skbecken/TreatTurbine/README.md

# The TreatTurbine

Autonomous UAV-mounted treat dispensing system developed in partnership with Alveus Sanctuary.

## Logo
<!-- PROJECT LOGO -->
<br />
<div align="center">
<a href="https://github.com/skbecken/TreatTurbine">
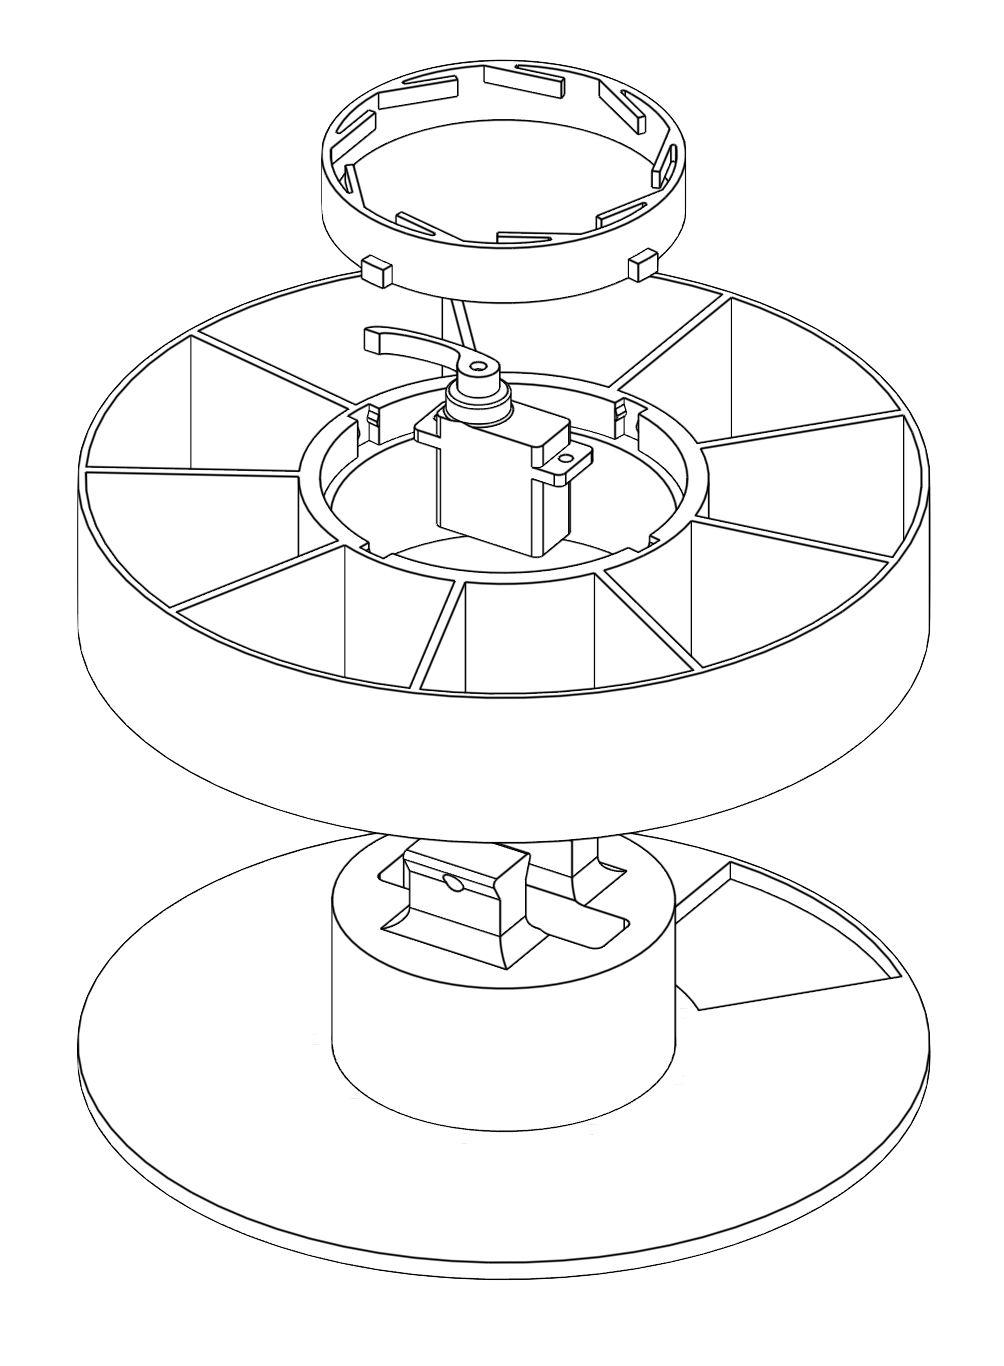
[picture p1: assets/diagrams/TreatTurbine_Exploded_View.png]

</a>

<h1 align="center">TreatTurbine</h1> 

 <p align="center">
    Autonomous UAV-mounted treat dispensing system developed in partnership with Alveus Sanctuary.
  </p>
  </div>

## Table of Contents
- Overview  
- Features  
- Hardware / Requirements  
- Getting Started  
- Usage  
- Documentation  
- Contributing  
- License  
- Contact  
- Acknowledgements  

## Overview
This system is designed to deliver small treats via an unmanned aerial vehicle (UAV). Its advantages include the capability to reach remote areas, perform pre-programmed jobs, and keep people far away from the animals it serves.

## Features
- Versatile design that works with different payloads and drone platforms  
- Designed to be inexpensive, easy to manufacture, and easy to use  

## Hardware / Requirements
What someone needs before they can use this system.

## Getting Started
Step-by-step instructions for going from zero to a working system.

## Usage
Instructions for operating the system once it is set up. Screenshots or diagrams may be helpful here.

## Documentation
To make the TreatTurbine more accessible, significant effort has been put into documenting the steps required to reproduce it. Instructions, usage notes, 3D print files, and software can be found in this GitHub repository.

A complete version of the Onshape CAD files, ready for modification, can be found here:  
https://cad.onshape.com/documents/a14a263d4646380f37314a8a/w/1a27b2a84b8e4b9b2ac841da/e/305afa125aeae7e1aa674fe5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

## Contributing
See `CONTRIBUTING.md` for contribution guidelines.

## License
Apache 2.0 License  
https://github.com/skbecken/TreatTurbine/blob/main/LICENSE

## Contact
- Sophia Becken — skbecken@bu.edu  
- Aidan Donovan — aidanmd@bu.edu  
- Harrison Grant — hgrant@bu.edu  
- Sofia Kamal — skamal9@bu.edu  
- Jason Sayah — jsnsayah@bu.edu  

Project Link:  
https://github.com/skbecken/TreatTurbine/tree/main

## Acknowledgements
- Alveus Sanctuary  
- Boston University  
- RASTIC  
- Team 223
