skbecken/TreatTurbine/06_Preflight_Checklist/preflight_checklist.md

#### The Ground Station
- [ ] Computer is charged for the duration of the flight
- [ ] Computer will not overheat/freeze in the elements
- [ ] Alerts are both visible and audible (test by changing flight mode while disarmed)
- [ ] SiK radio antenna has a clear view and is oriented correctly (pointed up in most conditions)
- [ ] Radio controller is adequately charged
- [ ] The autonomous flight path is valid
- [ ] Failsafe path and altitude are set correctly
- [ ] There are no gyro, accelerometer, GPS errors, or other critical error

#### The Aircraft
- [ ] Each propellor: snugly tightened CW and CCW, as appropriate 
- [ ] Wires: no loose or dangling wires close to propellors
- [ ] Battery voltage is appropriate for flight, but under no circumstances lower than 3.7V/cell (14.8V for a 4s battery) - note that reported percentage can be very misleading
- [ ] Takeoff/landing zone is clear (10ft radius with open sky)
- [ ] Good GPS lock (HDOP <1.2 and 8+ satellites)
- [ ] Battery is secure (passes wiggle test)
- [ ] Battery leads have tension and are not at risk of getting into props
- [ ] Compass is giving sane readings (verify North reads North etc)

#### The Pilot 
- [ ] IMSAFE 
  - [ ] Illness
  - [ ] Medication
  - [ ] Sleep
  - [ ] Alcohol
  - [ ] Fatigue
  - [ ] Emotion
- [ ] Adequate sunglasses/glasses for the distance and direction of flight
- [ ] Is confident in both their abilities and in the technical soundness of the aircraft

#### Regulatory (important, but not safety critical)
- [ ] Remote ID is charged and active
- [ ] Not operating in a no-fly zone
- [ ] Part 107 pilot present for any and all commercial operation
- [ ] Flight will not exceed visual line of site (or spotters are present along the way) without waiver
