skbecken/TreatTurbine/06_Preflight_Checklist/before_first_flight.md

check motor directions
check accels
do test while holding
PSU smoke test
calibrations
