skbecken/TreatTurbine/README_OLD.md

<!-- PROJECT LOGO -->
<br />
<div align="center">
<a href="https://github.com/skbecken/TreatTurbine">

</a>

<h1 align="center">TreatTurbine</h1> 

 <p align="center">
    Autonomous UAV-mounted treat dispensing system developed in partnership with Alveus Sanctuary.
  </p>
  </div>
  
<h2 align="left">Table of Contents</h2>

<h2 align="left">Overview</h2>
  <p align="left">
    This system is designed to deliver small treats via an unmanned aerial vehicle (UAV). Its advantages include the capability to reach remote areas, perform pre-programmed jobs, and keeping people far away from the animals it serves. 
  </p>
  </div>
  
<h2 align="left">Features</h2>
  <p align="left">
    - Versatile, designed to work with different payloads and different drone platforms
    - Designed to be cheap, easy to manufacture, and easy to use
    - 
  </p>
  </div>
  
<h2 align="left">Hardware / Requirements</h2>
  <p align="left">
    What someone needs before they can use this.
  </p>
  </div>
  
<h2 align="left">Getting Started</h2>
  <p align="left">
    Step by step — how to get from zero to working.
  </p>
  </div>

<h2 align="left">Usage</h2>
  <p align="left">
    How to actually operate it once set up.
    Screenshots or diagrams help here.
  </p>
  </div>

<h2 align="left">Documentation</h2>
  <p align="left">
    In order to make the Treat Turbine more accessible, considerable effort has gone into documenting and recording the steps required to reproduce it. Instructions, usage notes, 3D print files, and software, can be found in this Github repo. A complete version of the Onshape CAD files ready for your modifications can be found here: https://cad.onshape.com/documents/a14a263d4646380f37314a8a/w/1a27b2a84b8e4b9b2ac841da/e/305afa125aeae7e1aa674fe5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
  </p>
  </div>

<h2 align="left">Contributing</h2>
  <p align="left">
    Brief note + link to CONTRIBUTING.md
  </p>
  </div>

<h2 align="left">License</h2>
  <p align="left">
    Apache 2.0 License — \[LICENSE.md\](https://github.com/skbecken/TreatTurbine/blob/main/LICENSE)
  </p>
  </div>

<h2 align="left">Contact</h2>
<p align="left">
 
Sophia Becken - skbecken@bu.edu 

Aidan Donovan - aidanmd@bu.edu

Harrison Grant - hgrant@bu.edu

Sofia Kamal - skamal9@bu.edu

Jason Sayah - jsnsayah@bu.edu

Project Link: https://github.com/skbecken/TreatTurbine/tree/main
</p>
</div>

<h2 align="left">Acknowledgements</h2>
  <p align="left">
    Alveus Sanctuary, Boston University, RASTIC, Team 223
  </p>
  </div>
