skbecken/TreatTurbine/assets/diagrams/TreatTurbine_Exploded_S550.png

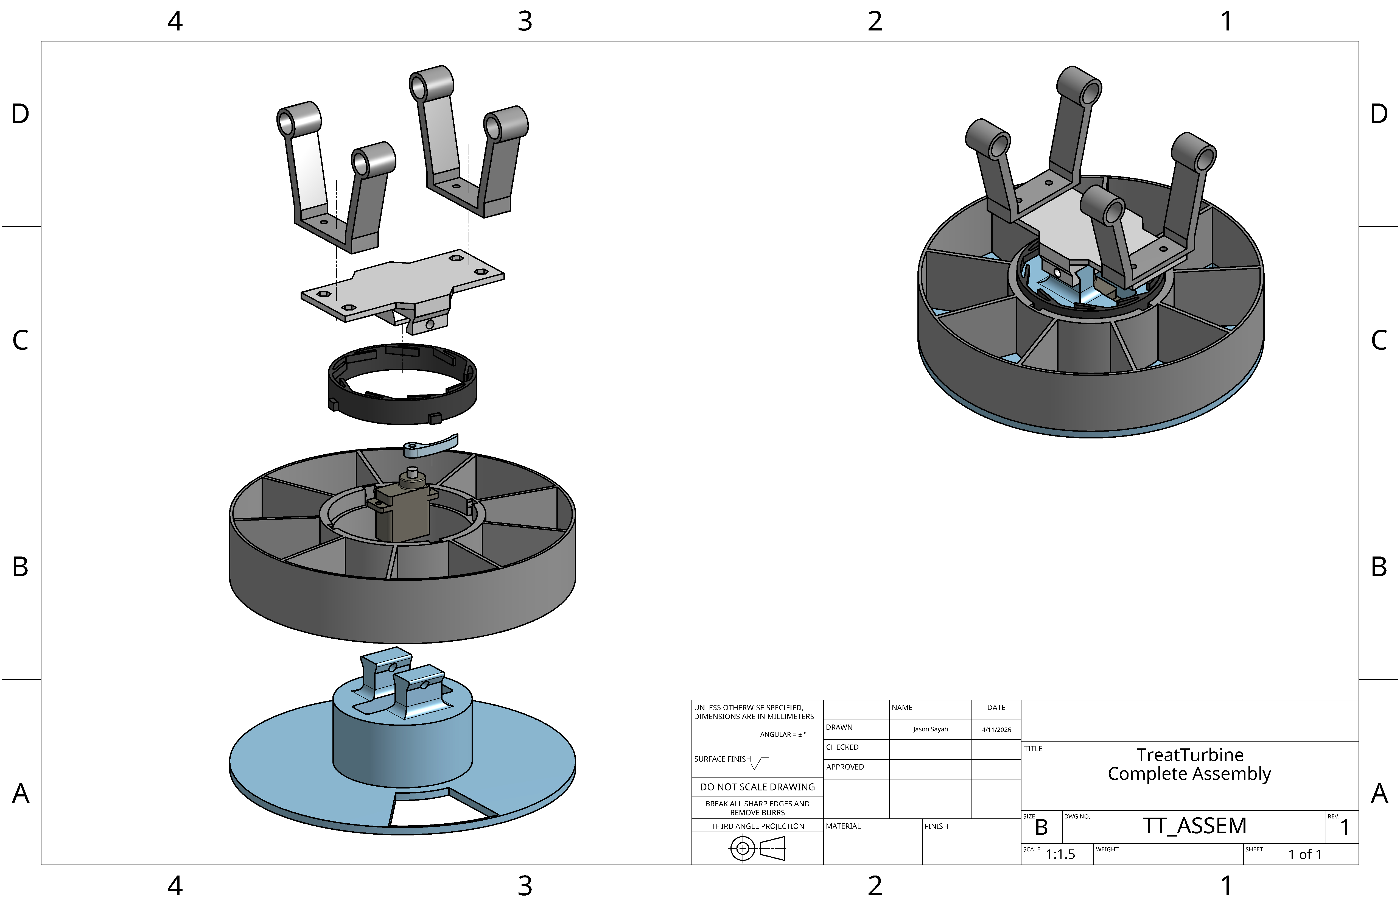
assets/diagrams/TreatTurbine_Exploded_S550.png
