skbecken/TreatTurbine/assets/photos/Team_Photo.jpg

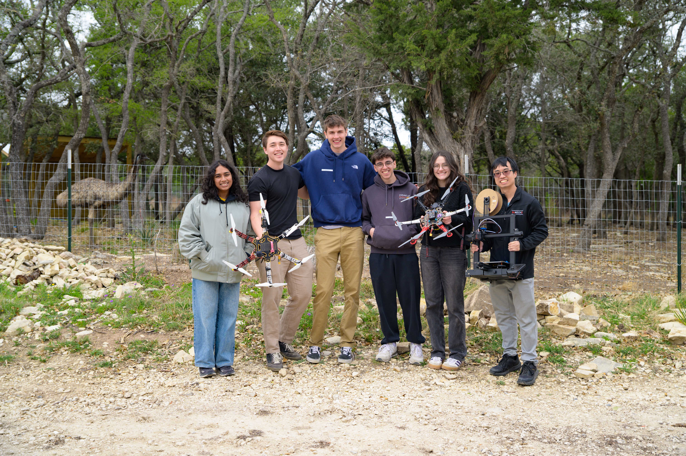
assets/photos/Team_Photo.jpg
