skbecken/TreatTurbine/assets/Screenshots/intro-to-Q.png

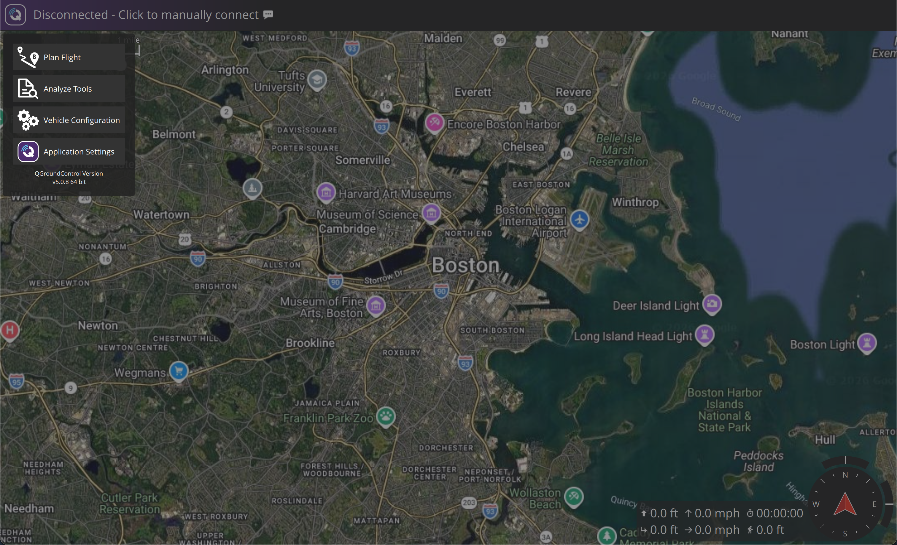
assets/Screenshots/intro-to-Q.png
