skbecken/TreatTurbine/01_Bill_of_Materials/bill_of_materials.md

# 01 - Bill of Materials

## What you can find here

- A complete breakdown of components our team used to build and fly the S550 autonomously while streaming video
- A complete breakdown of components in the TreatTurbine
- Information on part sourcing and cost

Note: These lists simply represent the parts Team 223 used in developing this project. Viable alternatives exist and are left to user discretion. 

## 

## S550 BOM

| Item | Part | Source | Cost |
|---|---|---|---|
| 1 | S550 Hexacopter Pack | Amazon | $299.99 |
| 2 | FrSky X8R Radio Receiver | Amazon | $38.99  |
| 3 | M8N GPS Module | Amazon | $31.24  |
| 4 | 3DR 500MW Radio Telemetry Kit | Amazon | $63.99  |
| 5 | 4S 6000 mAh LiPo Batteries | Ovonic | $66.64  |
| 6 | Walksnail Avatar VRX | RaceDayQuads | $262.99 |
| 7 | Walksnail Avatar GT VTX | RaceDayQuads | $235.99 |
| 8 | RadioMaster Pocket Radio | GetFPV | $71.49  |

## 

## TreatTurbine BOM

| Item | Part | Source | Weight (g) | Estimated Cost |
|---|---|---|---|---|
| 1 | Baseplate | 3D Print | 56 | $2.07 |
| 2 | Divider | 3D Print | 60.5 | $2.24 |
| 3 | Gear Ring | 3D Print | 6.3 | $0.20 |
| 4 | Servo Pawl | 3D Print | 0.3 | $0.01 |
| 5 | Mounting Plate and Sling | 3D Print | 22.6 | $0.84 |
| 6 | Camera Cage | 3D Print | 1.8 | $0.07 |
| 7 | Camera Mount | 3D Print | 3.1 | $0.10 |
| 8 | SG90 Servo | Amazon | 10 | $2.00 |
| 9 | 3mm x 3mm Magnets | Amazon | | $8.50 |
