skbecken/TreatTurbine/10_3D_Print_Files/servo_pawl.stl

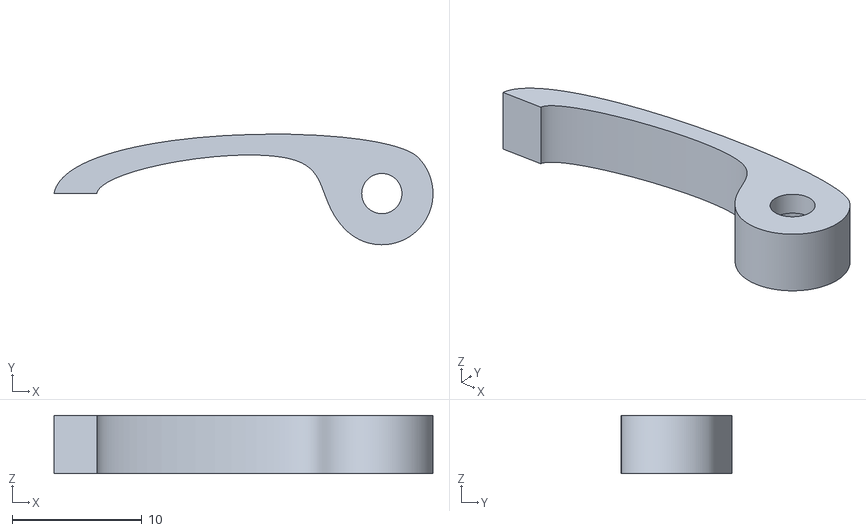
[picture p5: CAD file, 2026-04-06]
10_3D_Print_Files/servo_pawl.stl
29.2 x 8.53 x 4.50
