skbecken/TreatTurbine/10_3D_Print_Files/baseplate.stl

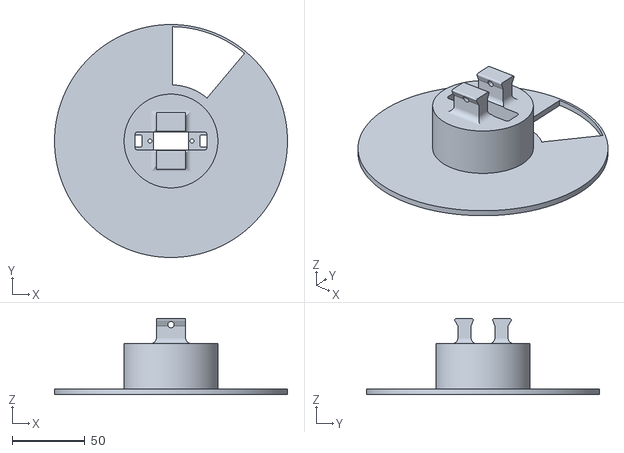
[picture p6: CAD file, 2026-04-06]
10_3D_Print_Files/baseplate.stl
160.0 x 160.0 x 52.2
