skbecken/TreatTurbine/10_3D_Print_Files/divider.stl

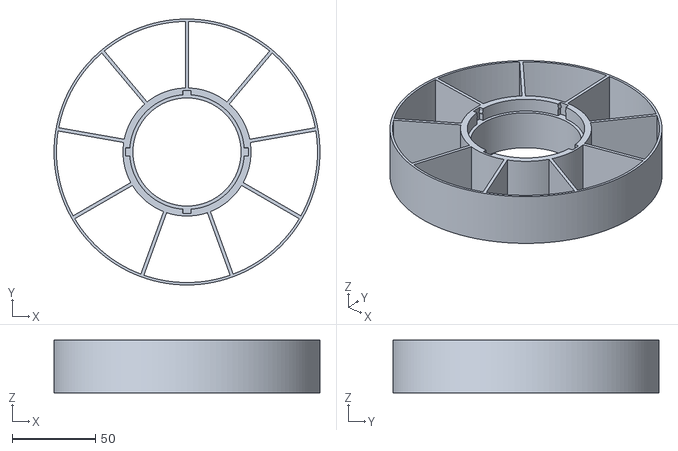
[picture p7: CAD file, 2026-04-06]
10_3D_Print_Files/divider.stl
160.0 x 160.0 x 31.8
