skbecken/TreatTurbine/10_3D_Print_Files/sling_plate.stl

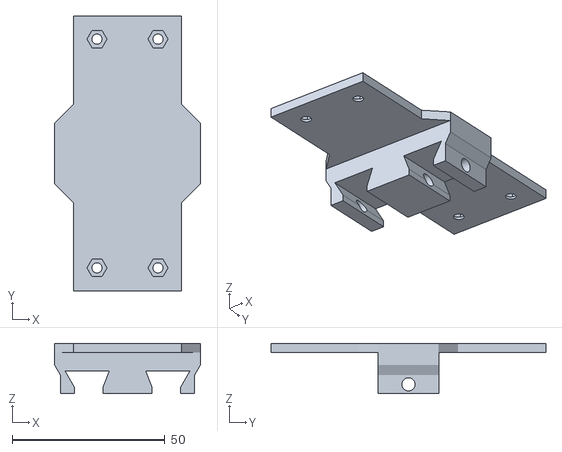
[picture p8: CAD file, 2026-04-06]
10_3D_Print_Files/sling_plate.stl
47.8 x 90.0 x 16.4
