skbecken/TreatTurbine/10_3D_Print_Files/gear_ring.stl

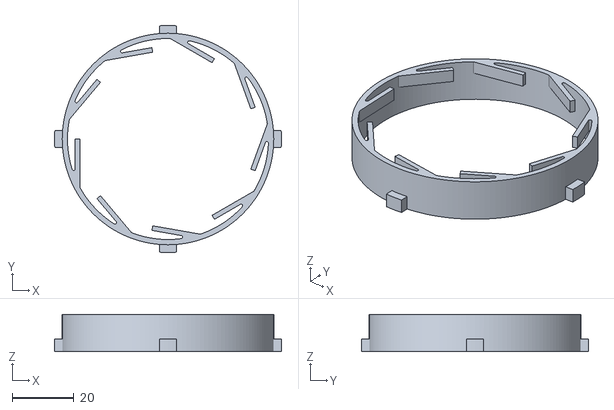
[picture p9: CAD file, 2026-04-06]
10_3D_Print_Files/gear_ring.stl
73.4 x 73.4 x 12.0
