skbecken/TreatTurbine/10_3D_Print_Files/sling_arm.stl

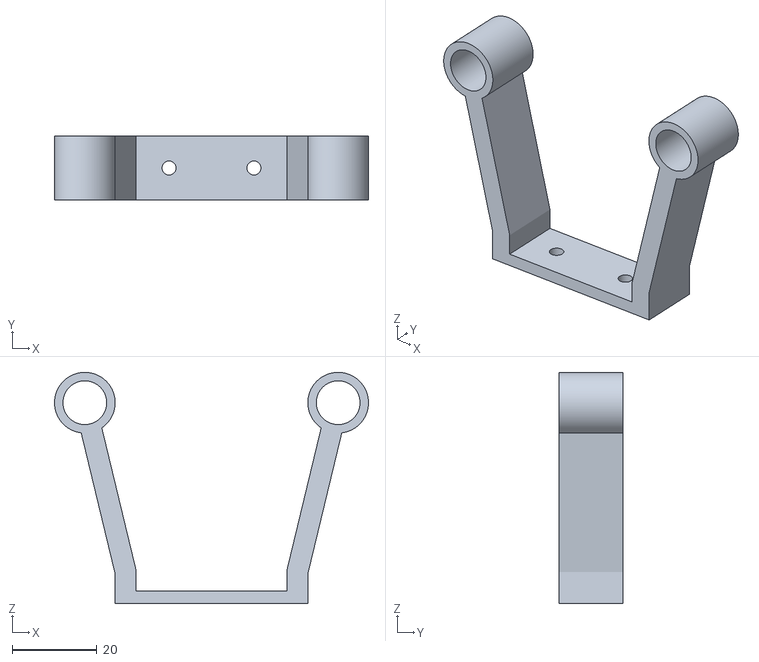
[picture p10: CAD file, 2026-04-06]
10_3D_Print_Files/sling_arm.stl
74.0 x 15.0 x 54.5
