skbecken/TreatTurbine/10_3D_Print_Files/camera_cage.stl

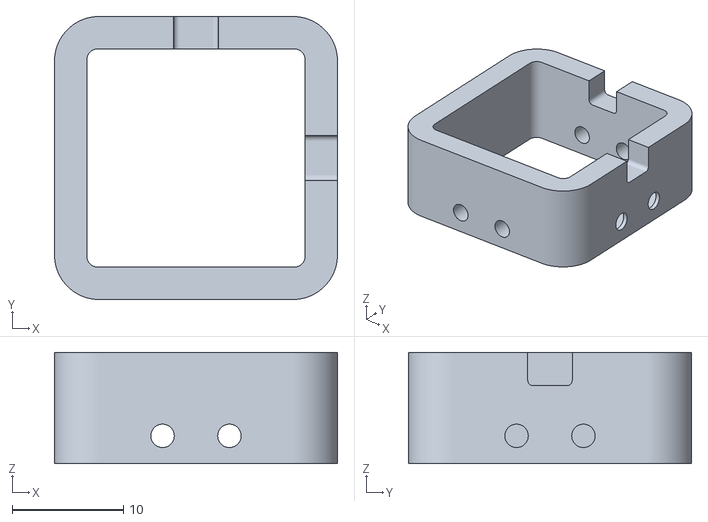
[picture p11: CAD file, 2026-04-06]
10_3D_Print_Files/camera_cage.stl
25.4 x 25.4 x 10.0
