skbecken/TreatTurbine/10_3D_Print_Files/mounting_plate.stl

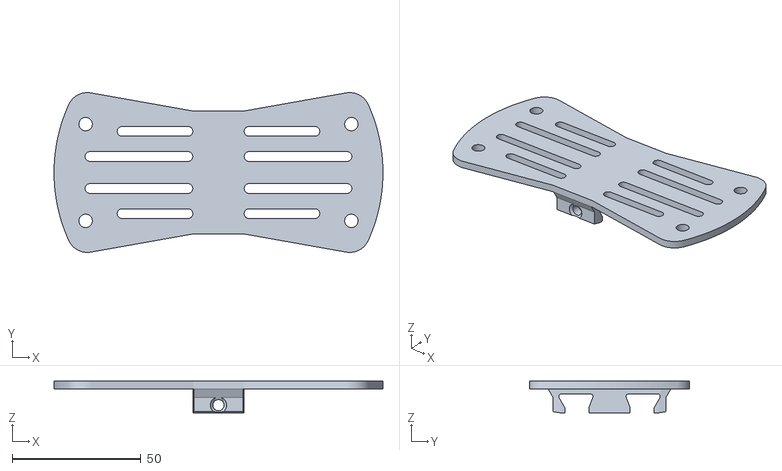
[picture p12: CAD file, 2026-04-06]
10_3D_Print_Files/mounting_plate.stl
128.0 x 62.2 x 12.4
