skbecken/TreatTurbine/10_3D_Print_Files/camera_mount.stl

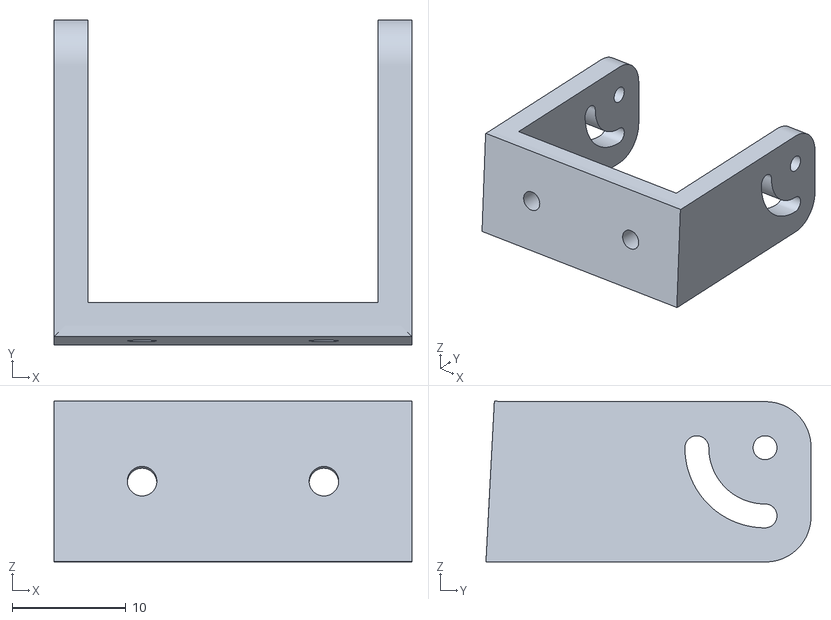
[picture p13: CAD file, 2026-04-06]
10_3D_Print_Files/camera_mount.stl
31.5 x 28.6 x 14.2
