skbecken/TreatTurbine/10_3D_Print_Files/10_print_settings.md

Do we need to provide these?
Maybe more of an info sheet than actual presets?
