skbecken/TreatTurbine/(commit log)

2026-03-27 Add Bill of Materials Document
2026-03-27 Add Assembly dir
2026-04-05 Add preflight checklist for ground station, aircraft, and pilot
2026-04-07 Create servo_and_dispenser_config.md with setup details
    Added documentation for electrical connections and Ardupilot configuration for the servo and dispenser system.
2026-04-16 added params from Alveus
    [F550-4-16-2026.params, S550-4-16-2026.params]
